RTimothyEdwards/sky130_ef_ip__ccomp3v/(commit log)

2024-03-01 Seeded repository from local project files.
    [analog_wrapper_tb.sch, comparator_bias.sch, comparator_core.sch, sky130_ef_ip__ccomp3v.sch, sky130_ef_ip__ccomp3v_tb.sch, user_analog_project_wrapper.sch]
2024-06-07 Updated the layout of the precision comparator to match changes made to the schematic to avoid a distortion at the high voltage end (high common-mode voltage), and to increase the sensitivity to 1mV 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
    [comparator_bias.sch, comparator_core.sch, sky130_ef_ip__ccomp3v.sch]
2024-06-12 Added an alternative version of the comparator to the repository. "sky130_ef_ip__ccomp3v_cl" has an additional input "CLOAD" that can be used to provide a load for a circuit such as a CDAC which gene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
    [comparator_core_cload.sch, sky130_ef_ip__ccomp3v_cl.sch]
2024-07-17 Added an enable signal to the comparator, to be input as a 1.8V domain signal and level-shifted to 3.3V. Modified schematic and layout, and re-ran LVS.
    [comparator_bias.sch, comparator_core.sch, comparator_core_cload.sch, sky130_ef_ip__ccomp3v.sch, sky130_ef_ip__ccomp3v_cl.sch, sky130_ef_ip__ccomp3v_tb.sch]
2024-09-15 Removed analog project wrappers from the ccomp IP block, because they should not be there and they interfere with xschem finding the correct wrapper cell when the IP block is used in an analog projec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
    [user_analog_project_wrapper.sch]
2024-10-25 Created a new comparator to use with the 12-bit CDAC for an ADC; this comparator has significantly more gain and should be able to meet the 12-bit resolution. However, it probably needs offset correc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
    [comparator_high_gain.sch, scomp_bias.sch, sky130_ef_ip__scomp3v.sch]
2024-10-26 Modified the simple comparator to increase the gain and remove the input offset (at least in the nominal case). Item to do: this circuit would benefit from an automatic input offset correction.
    [comparator_high_gain.sch, sky130_ef_ip__scomp3v_tb.sch]
2024-11-08 Added schematics and layout for the simple high-gain comparator to be used with the updated 12-bit ADC. The block passes DRC in magic, and LVS.
    [scomp_bias.sch, sky130_ef_ip__scomp3v.sch]
2024-11-20 Short ammeter in LVS netlist
    [comparator_high_gain.sch]
